azraful/Wireless-Tactile-Sensor/Dual_Sensor/Dual_Sensor.ino

//================================================================================
// This program successfully reads from two MLX90393 sensors in the same i2c bus.
//
//              Author: Azraful Awal Hamim
//              Project: Tactile Sensing Wireless Data Plotting
//              Supervisor: Dr. Lorenzo Jamone
//              Course: MSc Internet of Things (Data)
//              Sensor: MLX90393 Triaxis® Magnetic Field Sensor
//              Output: Forces in X,Y,Z axis
//              Microcontroller: ESP32              
//
// This code is open-source and different versions of it can be found elsewhere.
//================================================================================

#include<Wire.h>

// MLX90393 I2C Address is 0x0C(12) and 0x0E(14)
#define Addr 0x0C
#define Addr2 0x0E

void setup() 
{
  // Initialise I2C communication as MASTER 
  Wire.begin();
  // Initialise serial communication, set baud rate = 9600
  Serial.begin(9600);

  // Start I2C Transmission
  Wire.beginTransmission(Addr);
  // Select Write register command
  Wire.write(0x60);
  // Set AH = 0x00, BIST disabled
  Wire.write(0x00);
  // Set AL = 0x5C, Hall plate spinning rate = DEFAULT, GAIN_SEL = 5  
  Wire.write(0x5C);
  // Select address register, (0x00 << 2)
  Wire.write(0x00);
  // Stop I2C Transmission
  Wire.endTransmission();

   Wire.beginTransmission(Addr2);
  // Select Write register command
  Wire.write(0x60);
  // Set AH = 0x00, BIST disabled
  Wire.write(0x00);
  // Set AL = 0x5C, Hall plate spinning rate = DEFAULT, GAIN_SEL = 5  
  Wire.write(0x5C);
  // Select address register, (0x00 << 2)
  Wire.write(0x00);
  // Stop I2C Transmission
  Wire.endTransmission();

  // Request 1 byte of data
  Wire.requestFrom(Addr, 1);
  Wire.requestFrom(Addr2, 1);

  // Read status byte
  if(Wire.available() == 1) 
  {
    unsigned int c = Wire.read();
  }

  // Start I2C Transmission
  Wire.beginTransmission(Addr);
  // Select Write register command
  Wire.write(0x60);
  // Set AH = 0x02
  Wire.write(0x02);
  // Set AL = 0xB4, RES for magnetic measurement = 0
  Wire.write(0xB4);
  // Select address register, (0x02 << 2)
  Wire.write(0x08);
  // Stop I2C Transmission
  Wire.endTransmission();

  Wire.beginTransmission(Addr2);
  // Select Write register command
  Wire.write(0x60);
  // Set AH = 0x02
  Wire.write(0x02);
  // Set AL = 0xB4, RES for magnetic measurement = 0
  Wire.write(0xB4);
  // Select address register, (0x02 << 2)
  Wire.write(0x08);
  // Stop I2C Transmission
  Wire.endTransmission();

 
  // Request 1 byte of data
  Wire.requestFrom(Addr, 1);
  Wire.requestFrom(Addr2, 1);
  // Read status byte
  if(Wire.available() == 1) 
  {
   unsigned int c = Wire.read();
  }
  delay(300);
}

void loop() 
{
  unsigned int data[7];
  
  // Start I2C Transmission
  Wire.beginTransmission(Addr);
  // Start single meaurement mode,  ZYX enabled
  Wire.write(0x3E);
  // Stop I2C Transmission
  Wire.endTransmission();
  
  // Request 1 byte of data
  Wire.requestFrom(Addr, 1);
  
  // Read status byte
  if(Wire.available() == 1) 
  {
   unsigned int c = Wire.read();
  }
  delay(100);

  // Start I2C Transmission
  Wire.beginTransmission(Addr);
  // Send read measurement command, ZYX enabled
  Wire.write(0x4E);
  // Stop I2C Transmission
  Wire.endTransmission();
  
  // Request 7 bytes of data
  Wire.requestFrom(Addr, 7);

  // Read 7 bytes of data
  // status, xMag msb, xMag lsb, yMag msb, yMag lsb, zMag msb, zMag lsb
  if(Wire.available() == 7);
  {
    data[0] = Wire.read();
    data[1] = Wire.read();
    data[2] = Wire.read();
    data[3] = Wire.read();
    data[4] = Wire.read();
    data[5] = Wire.read();
    data[6] = Wire.read();
  }

  // Convert the data
  int xMag = data[1] * 256 + data[2];
  int yMag = data[3] * 256 + data[4];
  int zMag = data[5] * 256 + data[6];

  // Output data to serial monitor
  Serial.print("Magnetic Field in X-Axis : ");
  Serial.println(xMag);
  Serial.print("Magnetic Field in Y-Axis : ");
  Serial.println(yMag);
  Serial.print("Magnetic Field in Z-Axis : ");
  Serial.println(zMag);
  delay(2000);
  unsigned int data2[7];
  
  // Start I2C Transmission
  Wire.beginTransmission(Addr2);
  // Start single meaurement mode,  ZYX enabled
  Wire.write(0x3E);
  // Stop I2C Transmission
  Wire.endTransmission();
  
  // Request 1 byte of data
  Wire.requestFrom(Addr2, 1);
  
  // Read status byte
  if(Wire.available() == 1) 
  {
   unsigned int c = Wire.read();
  }
  delay(100);

  // Start I2C Transmission
  Wire.beginTransmission(Addr2);
  // Send read measurement command, ZYX enabled
  Wire.write(0x4E);
  // Stop I2C Transmission
  Wire.endTransmission();
  
  // Request 7 bytes of data
  Wire.requestFrom(Addr2, 7);

  // Read 7 bytes of data
  
  if(Wire.available() == 7);
  {
    data2[0] = Wire.read();
    data2[1] = Wire.read();
    data2[2] = Wire.read();
    data2[3] = Wire.read();
    data2[4] = Wire.read();
    data2[5] = Wire.read();
    data2[6] = Wire.read();
  }

  // Convert the data
  int xMag2 = data[1] * 256 + data[2];
  int yMag2 = data[3] * 256 + data[4];
  int zMag2 = data[5] * 256 + data[6];

  // Output data to serial monitor
  Serial.print("Magnetic Field in X-Axis 2: ");
  Serial.println(xMag2);
  Serial.print("Magnetic Field in Y-Axis 2: ");
  Serial.println(yMag2);
  Serial.print("Magnetic Field in Z-Axis 2: ");
  Serial.println(zMag2);
  delay(500);
}
